HexabitzPlatform/H2BR0x-Hardware/README.md

# H2RB0x-Hardware
Hexabitz EXG Monitor Module Hardware Design
