HexabitzPlatform/H2BR0x-Hardware/H2BR0-5/Rleased/BOM/H2BR0-5.xlsx

 |  | www.hexabitz.com info@hexabitz.com |  | Bill Of Materials
Customer | Hexabitz | Revision | 1
Project | Hexabitz Modules | Date | 2025-01-13
Board | EXG Monitor "EU Version" (H2BR0-5) | Notes
Designator | Description | MPN | MFN | Octopart Url | Quantity
Reset | Headers & Wire Housings Unshrouded 1 POS T/H | 5-146280-1 | TE Connectivity | https://octopart.com/5-146280-1-te+connectivity+%2F+amp-40259676?r=sp | 1
SWD, JP3 | Conn Unshrouded Header HDR 3 POS 2.54mm Solder ST Top Entry Thru-Hole Carton | 5-146281-3 | TE Connectivity | https://octopart.com/5-146281-3-te+connectivity+%2F+amp-39745942?r=sp | 2
JP4 | Conn Unshrouded Header HDR 2 POS 2.54mm Solder ST Top Entry Thru-Hole Carton | 5-146280-2 | TE Connectivity | https://octopart.com/5-146280-2-te+connectivity-146407?r=sp | 1
J1 | 3.5 mm, Stereo, Right Angle, Surface Mount (SMT), Audio Jack Connector | SJ-3524-SMT-TR | CUI Devices | https://octopart.com/sj-3524-smt-tr-cui+devices-106234236?r=sp | 1
J3 | Connector Header Through Hole 3 position 0.079" (2.00mm) | 440054-3 | TE Connectivity | https://octopart.com/440054-3-te+connectivity-40394845 | 1
S1 | JS Series Sub-Miniature Slide Switch DPDT On-On Top Slide 0.3A 6VDC J-Lead Surface Mount T/R | JS202011JCQN | C&K Components | https://octopart.com/js202011jcqn-c%26k+components-74831569?r=sp | 1
R2, R29, R30 | RES SMD 0.0OHM JUMPER 1/10W 0603 | RC0603JR-070RL | YAGEO | https://octopart.com/rc0603jr-070rl-yageo-1241539?r=sp | 3
R3 | Thick Film Resistors - SMD 0603 270 Ohm 5% Tol | ERJ-3GEYJ271V | Panasonic | https://octopart.com/erj-3geyj271v-panasonic-55560546?r=sp | 1
R26 | Surface Mount Thick Film Resistor, Rc Series, 680 Ohm, 100 Mw, - 5%, 50 V, 0603 | RC0603JR-07680RL | Yageo | https://octopart.com/rc0603jr-07680rl-yageo-40953172?r=sp | 1
R1 | RES 10K Ohm 1% 0603 | RC0603FR-0710KL | Yageo | https://octopart.com/rc0603fr-0710kl-yageo-40025538?r=sp | 1
R22 | RES 16K OHM 1% 1/16W 0402 | RC0402FR-0716KL | Yageo | https://octopart.com/rc0402fr-0716kl-yageo-39807370 | 1
R23, R31 | RES SMD 22K OHM 1% 1/10W 0402 | ERJ-2RKF2202X | Panasonic | https://octopart.com/erj-2rkf2202x-panasonic-12565836 | 2
R20, R21 | RES 32K OHM 1% 1/16W 0402 | RN73R1ETTP3202F50 | KOA Speer | https://octopart.com/rn73r1ettp3202f50-koa+speer-100209663 | 2
R24 | RES 47K OHM 1% 1/16W 0402 | RC0402FR-0747KL | Yageo | https://octopart.com/rc0402fr-0747kl-yageo-40301050 | 1
R16, R28 | RES 100K OHM 1% 1/16W 0402 | RC0402FR-07100KL | Yageo | https://octopart.com/rc0402fr-07100kl-yageo-55402861 | 2
R11, R12 | RES 180K OHM 1% 1/16W 0402 | RC0402FR-07180KL | YAGEO | https://octopart.com/rc0402fr-07180kl-yageo-40952506 | 2
R19, R27 | RES 200K OHM 1% 1/16W 0402 | RC0402FR-07200KL | Yageo | https://octopart.com/rc0402fr-07200kl-yageo-40254872 | 2
R25 | RES 330K OHM 1% 1/16W 0402 | RC0402FR-07330KL | Yageo | https://octopart.com/rc0402fr-07330kl-yageo-42471268 | 1
R13 | RES SMD 360K OHM 1% 1/10W 0402 | ERJ-2RKF3603X | Panasonic | https://octopart.com/erj-2rkf3603x-panasonic-43229254 | 1
R18 | RES 560K OHM 1% 1/16W 0402 | RC0402FR-07560KL | Yageo | https://octopart.com/rc0402fr-07560kl-yageo-39817352 | 1
R14 | RES 620K OHM 1% 1/16W 0402 | RC0402FR-07620KL | Yageo | https://octopart.com/rc0402fr-07620kl-yageo-39854269 | 1
R17 | RES 680K OHM 1% 1/16W 0402 | RC0402FR-13680KL | Yageo | https://octopart.com/rc0402fr-13680kl-yageo-25732090 | 1
R8 | RES 1.4M OHM 1% 1/16W 0402 | RC0402FR-071M4L | YAGEO | https://octopart.com/rc0402fr-071m4l-yageo-22124509 | 1
R15 | RES 1.8M OHM 1% 1/16W 0402 | RC0402FR-071M8L | Yageo | https://octopart.com/rc0402fr-071m8l-yageo-42624245 | 1
R4, R5, R6, R7, R9, R10 | RES SMD 10M OHM 1% 1/16W 0402 | AC0402FR-0710ML | YAGEO | https://octopart.com/ac0402fr-0710ml-yageo-30510705 | 6
C11 | CAP CER 1000PF 50V C0G 0402 | C1005C0G1H102J050BA | TDK Corporation | https://octopart.com/c1005c0g1h102j050ba-tdk-26013165 | 1
C12 | CAP CER 0402 1.5NF 10V ULTRA STA | C0402C152J8HACAUTO | KEMET | https://octopart.com/c0402c152j8hacauto-kemet-88080277 | 1
C13 | CAP CER 10000PF 16V X7R 0402 | C0402C103J4RACTU | KEMET | https://octopart.com/c0402c103j4ractu-kemet-128602 | 1
C8, C15, C16, C17, C18, C19, C20, C21 | 0.1 µF ±5% 16V Ceramic Capacitor X7R 0402 (1005 Metric) | CC0402JRX7R7BB104 | YAGEO | https://octopart.com/cc0402jrx7r7bb104-yageo-21707045 | 8
C1, C3, C6 | CAP CER 0.1 UF 25V 10% X7R 0603 | CL10B104KA8NNNC | Samsung Electro-Mechanics | https://octopart.com/cl10b104ka8nnnc-samsung-19831573?r=sp | 3
C9, C10 | 0.33 µF ±5% 16V Ceramic Capacitor X7R 0603 (1608 Metric) | CC0603JRX7R7BB334 | YAGEO | https://octopart.com/cc0402krx5r6bb334-yageo-21548561 | 2
C5 | CAP CER 1UF 10V X5R 0402 | C0402C105K8PAC7411 | KEMET | https://octopart.com/c0402c105k8pac7411-kemet-75146233?r=sp | 1
C4 | CAP CER 1 UF 16V X7R 0805 | CC0805KKX7R7BB105 | YAGEO [VA] | https://octopart.com/cc0805kkx7r7bb105-yageo-8376555?r=sp | 1
C2 | CAP CER 4.7UF 16V X7R 0805 | C0805C475K4RACTU | KEMET [VA] | https://octopart.com/c0805c475k4ractu-kemet-22859922?r=sp | 1
FB1 | Ind chip Bead Multi-Layer 30 ohms 25% 100MHZ Ferrite 1,5A 0603Punched paper T/R | MMZ1608Y300BTA00 | TDK | https://octopart.com/mmz1608y300bta00-tdk-7906990?r=sp | 1
D1, D2 | Red 0603 130° Clear 54 mcd 2 V Surface Mount ChipLED | VLMS1300-GS08 | Vishay | https://octopart.com/vlms1300-gs08-vishay-21709201?r=sp&s=0nXJNjGsSbWwqfqWlZv0EA | 2
D3 | TVS DIODE 3,3V 10,9V SOD323 | CDSOD323-T03SC | BOURNS INC | https://octopart.com/cdsod323-t03sc-bourns-10487153?r=sp | 1
U1 | MCU 32-bit ARM Cortex M0+ RISC 512KB Flash 1.8V/2.5V/3.3V 48-Pin UFQFPN EP Tray | STM32G0B1CEU6 | STMicroelectronics | https://octopart.com/stm32g0b1ceu6-stmicroelectronics-116363364?r=sp | 1
U2 | ECG and HRM IC Singl / Analog Front End - AF | AD8232ACPZ-R7 | Analog Devices | https://octopart.com/ad8232acpz-r7-analog+devices-21053983?r=sp | 1
U3 | Op Amp Dual High Bandwidth Amplifier R-R I/O 5.5V 8-Pin DFN EP T/R | TSV772IQ2T | STMicroelectronics | https://octopart.com/tsv772iq2t-stmicroelectronics-123138659?r=sp | 1
X1 | 8,0000MHZ 33pF SMD MURATA Resonators | CSTNE8M00G550000R0 | Murata | https://octopart.com/cstne8m00g550000r0-murata-91406934?r=sp | 1
CAB1 | Right angle Gold plated 3.5mm Audio Plug to 3 Leads 3.5mm/4.0mm Female Electric Snap Connector ECG Cable | XR001650 | Alibaba | https://www.alibaba.com/product-detail/Right-angle-Gold-plated-3-5mm_1600978965655.html | 1
CAB2 | BioAmp Cable v3 (Record EEG, EMG, ECG, EOG) |  | Upside Down Labs | https://www.tindie.com/products/upsidedownlabs/bioamp-cable-v3-record-eeg-emg-ecg-eog/ | 1
Band1 | Brain BioAmp Band - Multi Channel EEG Band |  | Upside Down Labs | https://www.tindie.com/products/upsidedownlabs/brain-bioamp-band-multi-channel-eeg-band/ | 1
SH1 | RF Shield Cover 0.672" (17.07mm) X 0.672" (17.07mm) Non-Vented Surface Mount | SMS-402C | Leader Tech Inc. | https://octopart.com/sms-402c-leader+tech-82381431 | 1
