HexabitzPlatform/H2BR0x-Hardware/H2BR0-5/Documentation/H2BR0-5 Schematics.pdf

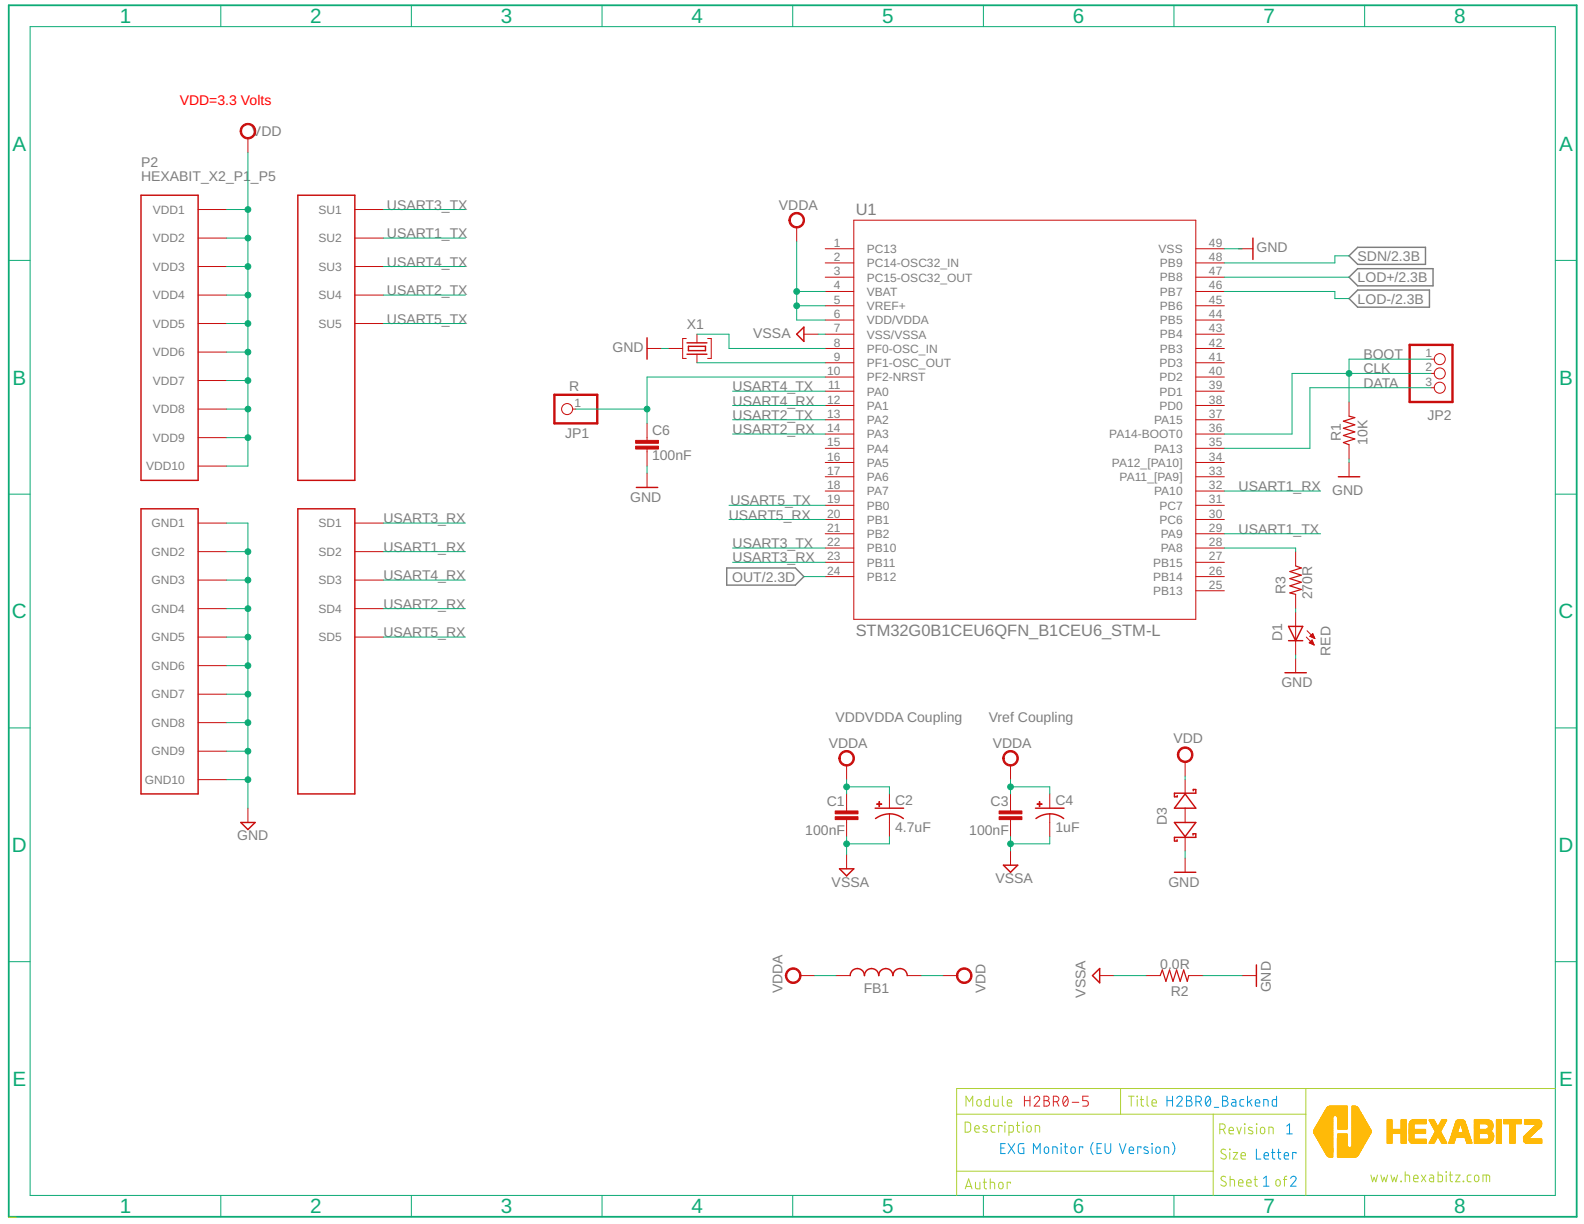
[picture p3: page 1]

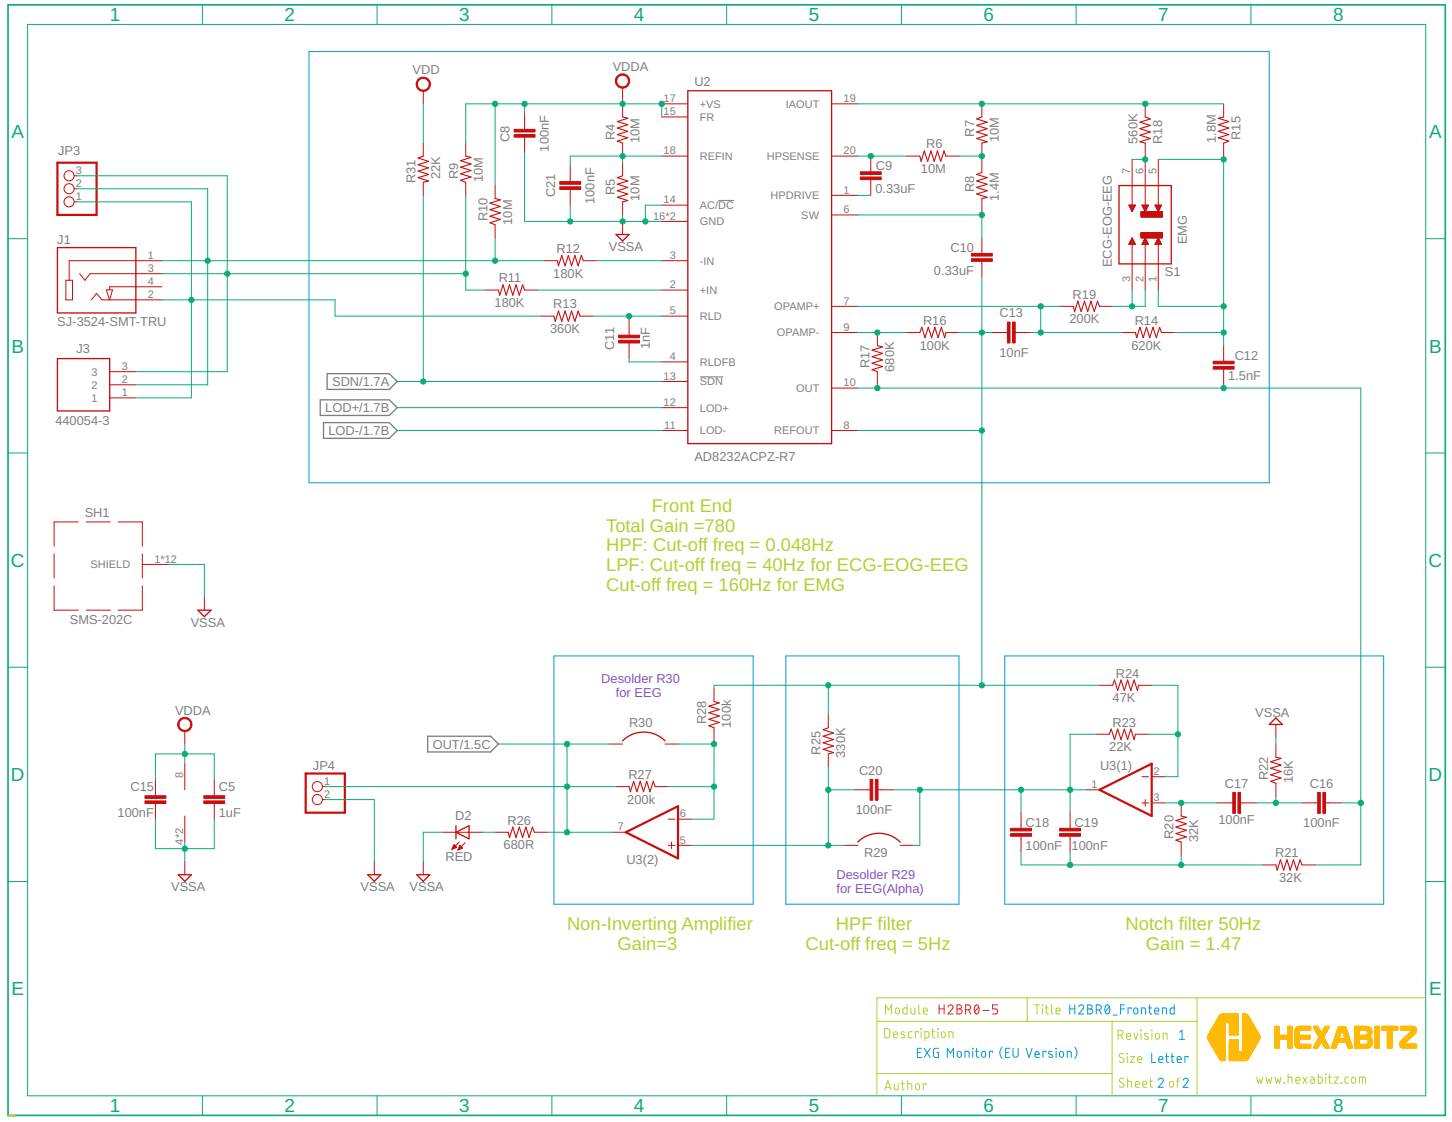
[picture p4: page 2]

Front End
Total Gain =780
HPF: Cut-off freq = 0.048Hz
LPF: Cut-off freq = 40Hz for ECG-EOG-EEG
Cut-off freq = 160Hz for EMG
