HexabitzPlatform/H2BR0x-Hardware/H2BR0-6/Design/H2BR0-6.brd

## EAGLE design H2BR0-6/Design/H2BR0-6.brd (2025-01-21)

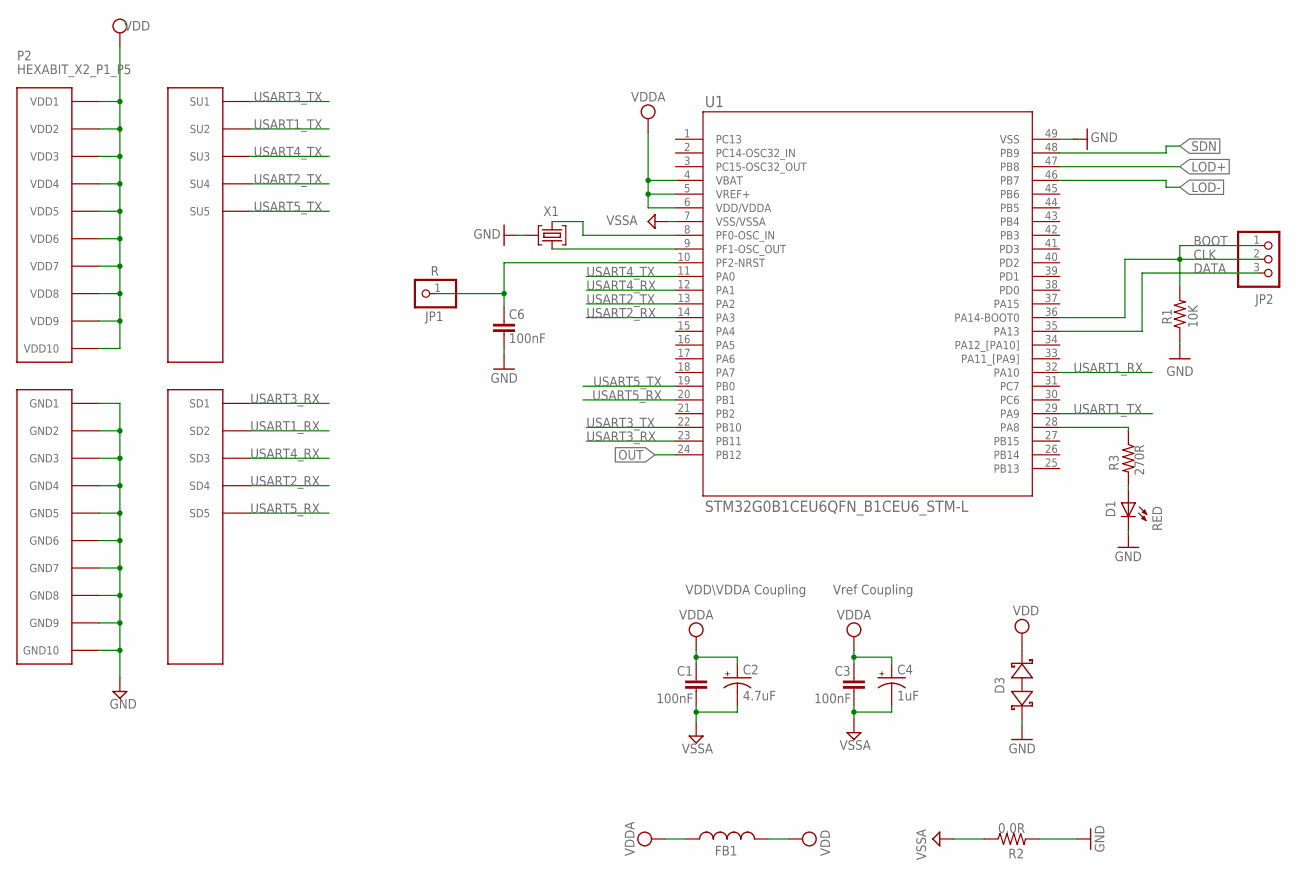
[picture p5: schematic H2BR0-6.sch, sheet 1]

Parts:
C1, C3, C6: 100nF; C-0603
C2: 4.7uF; C-0805-POL
C4: 1uF; C-0805-POL
D1: RED; VLMS1300-GS08; MPN VLMS1300-GS08
D3: BOURNS_CDSOD323-T03SCBOURNS_CDSOD323-T03SC_0_0; BOURNS_CDSOD323-T03SC_0
FB1: FB-0603
JP1: R; 1X01
JP2: PINHD-1X3; 1X03
P2: HEXABIT_X2_P1_P5; HEXABIT_17.32_X2_P1_P5
R1: 10K; R-0603
R2: 0.0R; R-0603
R3: 270R; R-0603
TRIMBLE-LOGO2: HEXA-LOGO
U1: STM32G0B1CEU6QFN_B1CEU6_STM-L; QFN_B1CEU6_STM-L
X1: XTALL_CSTCE8M00G52

Connections:
CLK: JP2.1, JP2.2, R1.2, U1.36 (PA14-BOOT0)
DATA: JP2.3, U1.35 (PA13)
GND: C6.2, D1.C, D3.1 (A), P2.PAD_PD11 (GND1), P2.PAD_PD12 (GND2), P2.PAD_PD13 (GND3), P2.PAD_PD14 (GND4), P2.PAD_PD15 (GND5), P2.PAD_PD16 (GND6), P2.PAD_PD17 (GND7), P2.PAD_PD18 (GND8), P2.PAD_PD19 (GND9), P2.PAD_PD20 (GND10), R1.1, R2.2, U1.49 (VSS), X1.P$2 (2)
LOD+: U1.47 (PB8); also elsewhere on the board
LOD-: U1.46 (PB7); also elsewhere on the board
unnamed: D1.A, R3.2
unnamed: R3.1, U1.28 (PA8)
unnamed: U1.9 (PF1-OSC_OUT), X1.P$1 (1)
unnamed: U1.8 (PF0-OSC_IN), X1.P$3 (3)
unnamed: C6.1, JP1.1, U1.10 (PF2-NRST)
OUT: U1.24 (PB12); also elsewhere on the board
SDN: U1.48 (PB9); also elsewhere on the board
USART1_RX: P2.PAD_PD2 (SD2), U1.32 (PA10)
USART1_TX: P2.PAD_PU2 (SU2), U1.29 (PA9)
USART2_RX: P2.PAD_PD4 (SD4), U1.14 (PA3)
USART2_TX: P2.PAD_PU4 (SU4), U1.13 (PA2)
USART3_RX: P2.PAD_PD1 (SD1), U1.23 (PB11)
USART3_TX: P2.PAD_PU1 (SU1), U1.22 (PB10)
USART4_RX: P2.PAD_PD3 (SD3), U1.12 (PA1)
USART4_TX: P2.PAD_PU3 (SU3), U1.11 (PA0)
USART5_RX: P2.PAD_PD5 (SD5), U1.20 (PB1)
USART5_TX: P2.PAD_PU5 (SU5), U1.19 (PB0)
VDD: D3.2 (C), FB1.2, P2.PAD_PU11 (VDD1), P2.PAD_PU12 (VDD2), P2.PAD_PU13 (VDD3), P2.PAD_PU14 (VDD4), P2.PAD_PU15 (VDD5), P2.PAD_PU16 (VDD6), P2.PAD_PU17 (VDD7), P2.PAD_PU18 (VDD8), P2.PAD_PU19 (VDD9), P2.PAD_PU20 (VDD10); also elsewhere on the board
VDDA: C1.1, C2.1 (+), C3.1, C4.1 (+), FB1.1, U1.4 (VBAT), U1.5 (VREF+), U1.6 (VDD/VDDA); also elsewhere on the board
VSSA: C1.2, C2.2 (-), C3.2, C4.2 (-), R2.1, U1.7 (VSS/VSSA); also elsewhere on the board

Notes on the sheet:
Vref Coupling
VDD\VDDA Coupling
BOOT

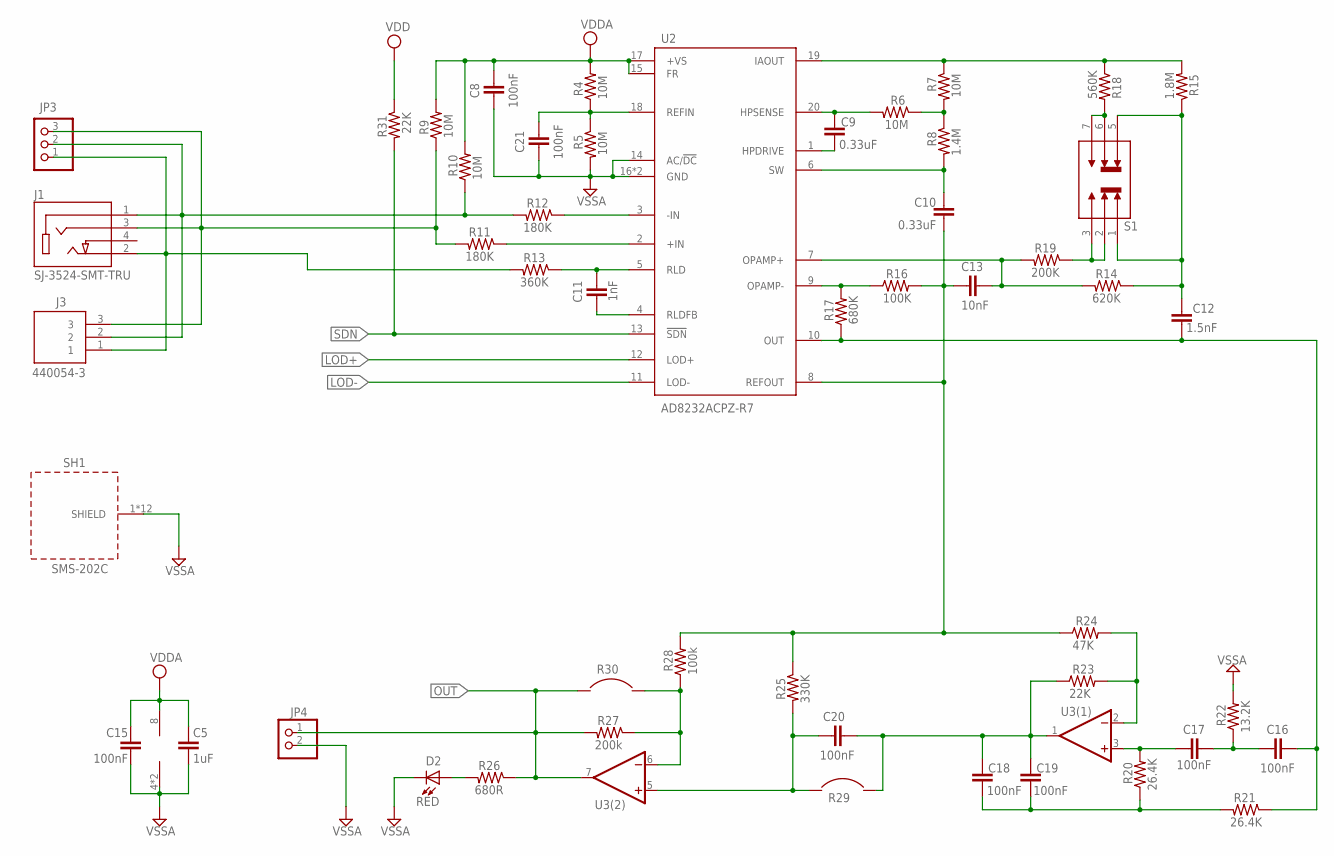
[picture p6: schematic H2BR0-6.sch, sheet 2]

Parts:
C5: 1uF; C-0402
C8, C15, C16, C17, C18, C19, C21: 100nF; C-0402
C9, C10: 0.33uF; C-0402
C11: 1nF; C-0402
C12: 1.5nF; C-0402
C13: 10nF; C-0402
C20: 100nF; C-0402; MPN GRM188R61A105KA61J
D2: RED; VLMS1300-GS08; MPN VLMS1300-GS08
J1: SJ-3524-SMT-TRU; CUI_SJ-3524-SMT
J3: 440054-3; SHDR3W50P0X200_1X3_800X470X635
JP3: PINHD-1X3; 1X03
JP4: PINHD-1X2(ROUND); 1X02
R4, R5, R6, R7, R9, R10: 10M; R-0402
R8: 1.4M; R-0402
R11, R12: 180K; R-0402
R13: 360K; R-0402
R14: 620K; R-0402
R15: 1.8M; R-0402
R16: 100K; R-0402
R17: 680K; R-0402
R18: 560K; R-0402
R19: 200K; R-0402
R20, R21: 26.4K; R-0402
R22: 13.2K; R-0402
R23, R31: 22K; R-0402
R24: 47K; R-0402
R25: 330K; R-0402
R26: 680R; R-0603
R27: 200k; R-0402
R28: 100k; R-0402
R29, R30: SB-0603
S1: JS202011JCQN; SW_JS202011JCQN
SH1: SMS-202C; SMS202F
U2: AD8232ACPZ-R7; QFN50P400X400X80-21N
U3: TSV772IQ2T_SEPARATED_SYMBOLSSON50P200X200X60-9N; SON50P200X200X60-9N

Connections:
IN+: J1.3, J3.3, JP3.3, R9.1, R11.2
IN-: J1.1, J3.2, JP3.2, R10.1, R12.2
LOD+: U2.12 (LOD+); also elsewhere on the board
LOD-: U2.11 (LOD-); also elsewhere on the board
unnamed: R16.1, R17.2, U2.9 (OPAMP-)
unnamed: C12.1, C16.2, R17.1, R21.1, U2.10 (OUT)
unnamed: C13.1, R14.2, R19.2, U2.7 (OPAMP+)
unnamed: R27.1, R28.1, R30.2, U3.6 (-IN)
unnamed: R19.1, S1.2, S1.3
unnamed: R18.2, S1.6, S1.7
unnamed: C12.2, R14.1, R15.1, S1.1, S1.5
unnamed: R7.1, R15.2, R18.1, U2.19 (IAOUT)
unnamed: C9.1, R6.2, U2.20 (HPSENSE)
unnamed: C9.2, U2.1 (HPDRIVE)
unnamed: R6.1, R7.2, R8.1
unnamed: R23.2, R24.2, U3.2 (-IN)
unnamed: C21.1, R4.1, R5.1, U2.18 (REFIN)
unnamed: C18.1, C19.1, R20.1, R21.2
unnamed: C11.1, R13.1, U2.5 (RLD)
unnamed: C17.1, R20.2, U3.3 (+IN)
unnamed: C18.2, C19.2, C20.2, R23.1, R29.2, U3.1 (OUT)
unnamed: C16.1, C17.2, R22.1
unnamed: C20.1, R25.2, R29.1, U3.5 (+IN)
unnamed: C10.2, C13.2, R16.2, R24.1, R25.1, R28.2, U2.8 (REFOUT)
unnamed: C10.1, R8.2, U2.6 (SW)
unnamed: D2.A, R26.2
unnamed: C11.2, U2.4 (RLDFB)
unnamed: R12.1, U2.3 (-IN)
unnamed: R11.1, U2.2 (+IN)
OUT: JP4.1, R26.1, R27.2, R30.1, U3.7 (OUT); also elsewhere on the board
REF: J1.2, J3.1, JP3.1, R13.2
SDN: R31.2, U2.13 (!SDN); also elsewhere on the board
VDD: R31.1; also elsewhere on the board
VDDA: C5.1, C8.1, C15.1, R4.2, R9.2, R10.2, U2.15 (FR), U2.17 (+VS), U3.8 (V+); also elsewhere on the board
VSSA: C5.2, C8.2, C15.2, C21.2, D2.C, JP4.2, R5.2, R22.2, SH1.1, SH1.2, SH1.3, SH1.4, SH1.5, SH1.6, SH1.7, SH1.8, SH1.9, SH1.10, SH1.11, SH1.12, U2.14 (AC/!DC), U2.16 (GND), U2.21 (GND), U3.4 (V-), U3.9 (V-); also elsewhere on the board

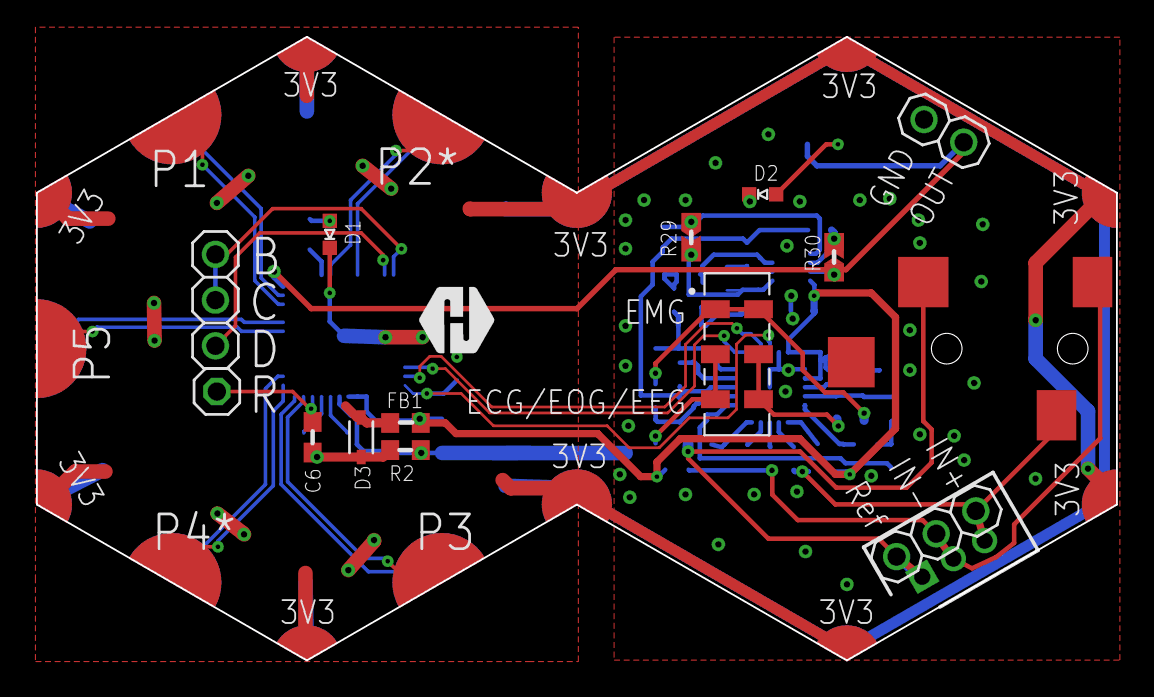
[picture p7: board H2BR0-6.brd from above]

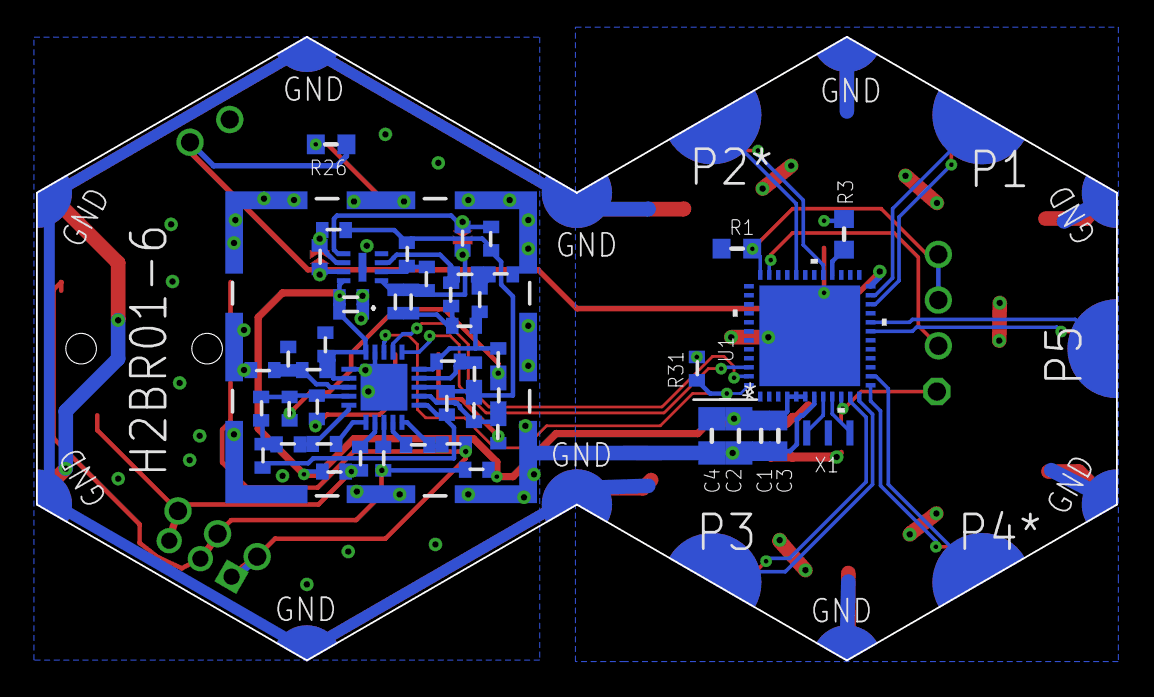
[picture p8: board H2BR0-6.brd from below]

Board: 2 copper layers, 60.0 x 34.6 mm, 68 parts (51 on the bottom side), 53 nets.
