HexabitzPlatform/H2BR0x-Hardware/(commit log)

2023-02-15 -Correcting some documentaion issues
    [H2BR00.xlsx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]
2023-09-23 -Update BOM
    [H2BR00.xlsx]
2024-07-19 -Add TVS diode -Change the MCU to STM32G0B1CEU6 -Activate the thermal option for the polygon -Update the logo -Add jumber resistor to edit the filter
    [H2BR0.brd, H2BR0.sch, H2BR0.xlsx, H2BR00.brd, H2BR00.sch, H2BR00.xlsx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]
2025-01-14 -The final design, all done.
    [H2BR0-5.brd, H2BR0-5.sch, H2BR0-5.xlsx, H2BR0.xlsx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]
2025-01-21 Adding the 60Hz version.
    [H2BR0-5.xlsx, H2BR0-6.brd, H2BR0-6.sch, H2BR0-6.xlsx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]
