HexabitzPlatform/H2BR0x-Hardware/(notices)

Notices in the files:
parts and their libraries:
COPYRIGHT: Copyright (C) 2021 Ultra Librarian. All rights reserved.
HEXABITZ_ICs: COPYRIGHT: Copyright (C) 2022 Ultra Librarian. All rights reserved.
